kliment/cctwiddler/ccsniffer-assembly/ccsniffer-back-noparts.png

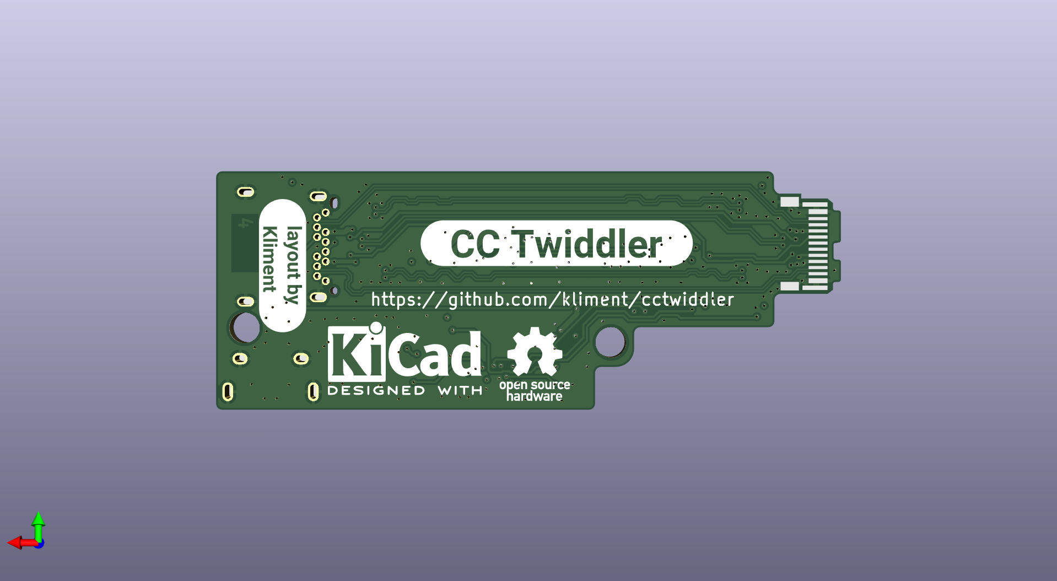
ccsniffer-assembly/ccsniffer-back-noparts.png
