kliment/cctwiddler/ccsniffer-assembly/ccsniffer-bom.xlsx

LIN | RD | Value | Footprint | Quantity | Description | Note | Manufacturer | MPN | Distributor | DPN | URL
1 | C1 | 4.7u | Capacitor_SMD:C_0603_1608Metric | 1 | Capacitor 4.7uF 16V X7R 0603
2 | C2, C3, C9 | 1u | Capacitor_SMD:C_0402_1005Metric | 3 | Capacitor 1uF 10V X7R 0402
3 | C4-C7 | 100n | Capacitor_SMD:C_0402_1005Metric | 4 | Capacitor 100nF 25V X7R 0402
4 | C8 | 10n | Capacitor_SMD:C_0402_1005Metric | 1 | Capacitor 10nF 25V X7R 0402
5 | D1 | MHT194CRGBCT | LED_SMD:LED_LiteOn_LTST-C19HE1WT | 1 | RGB LED |  | Meihua | MHT194CRGBCT | LCSC | C404275 | https://www.lcsc.com/product-detail/Light-Emitting-Diodes-LED_MEIHUA-MHT194CRGBCT_C404275.html
6 | J1 | USB_C_Receptacle | Connector_USB:USB_C_Receptacle_Amphenol_12401548E4-2A | 1 | USB-C 3.1 receptacle hybrid | This part is difficult to source | Amphenol | 12401548E4#2A
7 | J2 | USB_B_Micro | Connector_USB:USB_Micro-B_Amphenol_10118194_Horizontal | 1 | Micro-USB connector |  | Amphenol | 10118194-0001LF
8 | P1 | USB_C_Plug | Connector_USB:USB_C_Plug_JAE_DX07P024AJ1 | 1 | USB-C connector side mount |  | JAE Electronics | DX07P024AJ1R1500 | LCSC | C5352764 | https://www.lcsc.com/product-detail/USB-Connectors_JAE-Electronics-DX07P024AJ1R1500_C5352764.html
9 | Q1-Q6 | PMZ600UNEYL | Package_TO_SOT_SMD:SOT-883 | 6 | N-channel MOSFET |  | Nexperia | PMZ600UNEYL | LCSC | C547286 | https://www.lcsc.com/product-detail/MOSFETs_Nexperia-PMZ600UNEYL_C547286.html
10 | R1, R2 | CSS0805FT15L0 | Resistor_SMD:R_0805_2012Metric | 2 | Current sense R 15mOhm 0.5W 1% 0805 |  | Stackpole Electronics | CSS0805FT15L0 | Digikey |  | https://www.digikey.de/de/products/detail/stackpole-electronics-inc/CSS0805FT15L0/13930229
11 | R3, R11 | 381k | Resistor_SMD:R_0402_1005Metric | 2 | Resistor 381k 1% 0402
12 | R6, R14 | 5.1k | Resistor_SMD:R_0402_1005Metric | 2 | Resistor 5.1k 1% 0402
13 | R7, R15 | 12.1k | Resistor_SMD:R_0402_1005Metric | 2 | Resistor 12.1k 1% 0402
14 | R9, R17 | 100R | Resistor_SMD:R_0402_1005Metric | 2 | Resistor 100R 1% 0402
15 | R10, R18 | 200R | Resistor_SMD:R_0402_1005Metric | 2 | Resistor 200R 1% 0402
16 | R4, R12, R19-R21 | 1k | Resistor_SMD:R_0402_1005Metric | 5 | Resistor 1k 1% 0402
17 | R8, R16, R22 | 35.7k | Resistor_SMD:R_0402_1005Metric | 3 | Resistor 35.7k 1% 0402
18 | R5, R13, R23, R24 | 4.75k | Resistor_SMD:R_0402_1005Metric | 4 | Resistor 4.75k 1% 0402
19 | SW1 | PTS810-SJK-250-SMTR-LFS | Button_Switch_SMD:SW_SPST_PTS810 | 1 | Push button |  | C&K | PTS810-SJK-250-SMTR-LFS | LCSC | C221896 | https://www.lcsc.com/product-detail/Tactile-Switches_C-K-PTS810SJK250SMTRLFS_C221896.html
20 | U1 | STM32F072CBU6 | Package_DFN_QFN:QFN-48-1EP_7x7mm_P0.5mm_EP5.6x5.6mm | 1 | Microcontroller Cortex-M0 |  | STMicroelectronics | STM32F072CBU6 | LCSC | C92504 | https://www.lcsc.com/product-detail/Microcontroller-Units-MCUs-MPUs-SOCs_STMicroelectronics-STM32F072CBU6_C92504.html
21 | U2 | MAX4232AKA+T | Package_TO_SOT_SMD:SOT-23-8 | 1 | Dual opamp SOT-23-8 |  | Analog Devices | MAX4232AKA+T | LCSC | C87614 | https://www.lcsc.com/product-detail/Operational-Amplifier_Analog-Devices-Inc-Maxim-Integrated-MAX4232AKA-T_C87614.html
22 | U3 | TPD4E02B04DQA | Package_SON:USON-10_2.5x1.0mm_P0.5mm | 1 | ESD protection array |  | TI | TPD4E02B04DQA | LCSC | C106794 | https://www.lcsc.com/product-detail/ESD-Protection-Devices_Texas-Instruments-TPD4E02B04DQAR_C106794.html
23 | U4, U5 | INA231AIYFFR | ccsnifferparts:Texas_DSBGA-12_1.65x1.39mm_P0.4mm_YFF0012 | 2 | Current sensor IC |  | TI | INA231AIYFFR | Digikey |  | https://www.digikey.de/en/products/detail/INA231AIYFFR/296-41263-1-ND/5222728?curr=usd
24 | U6 | TCR2EF33,LM(CT | ccsnifferparts:SC-74A | 1 | Voltage regulator 3.3V SC-74A |  | Toshiba | TCR2EF33,LM(CT | LCSC | C843273 | https://www.lcsc.com/product-detail/Linear-Voltage-Regulators-LDO_TOSHIBA-TCR2EF33-LM-CT_C843273.html
