kliment/cctwiddler/ccsniffer.kicad_pcb

## KiCad design ccsniffer.kicad_pcb (2023-10-30)

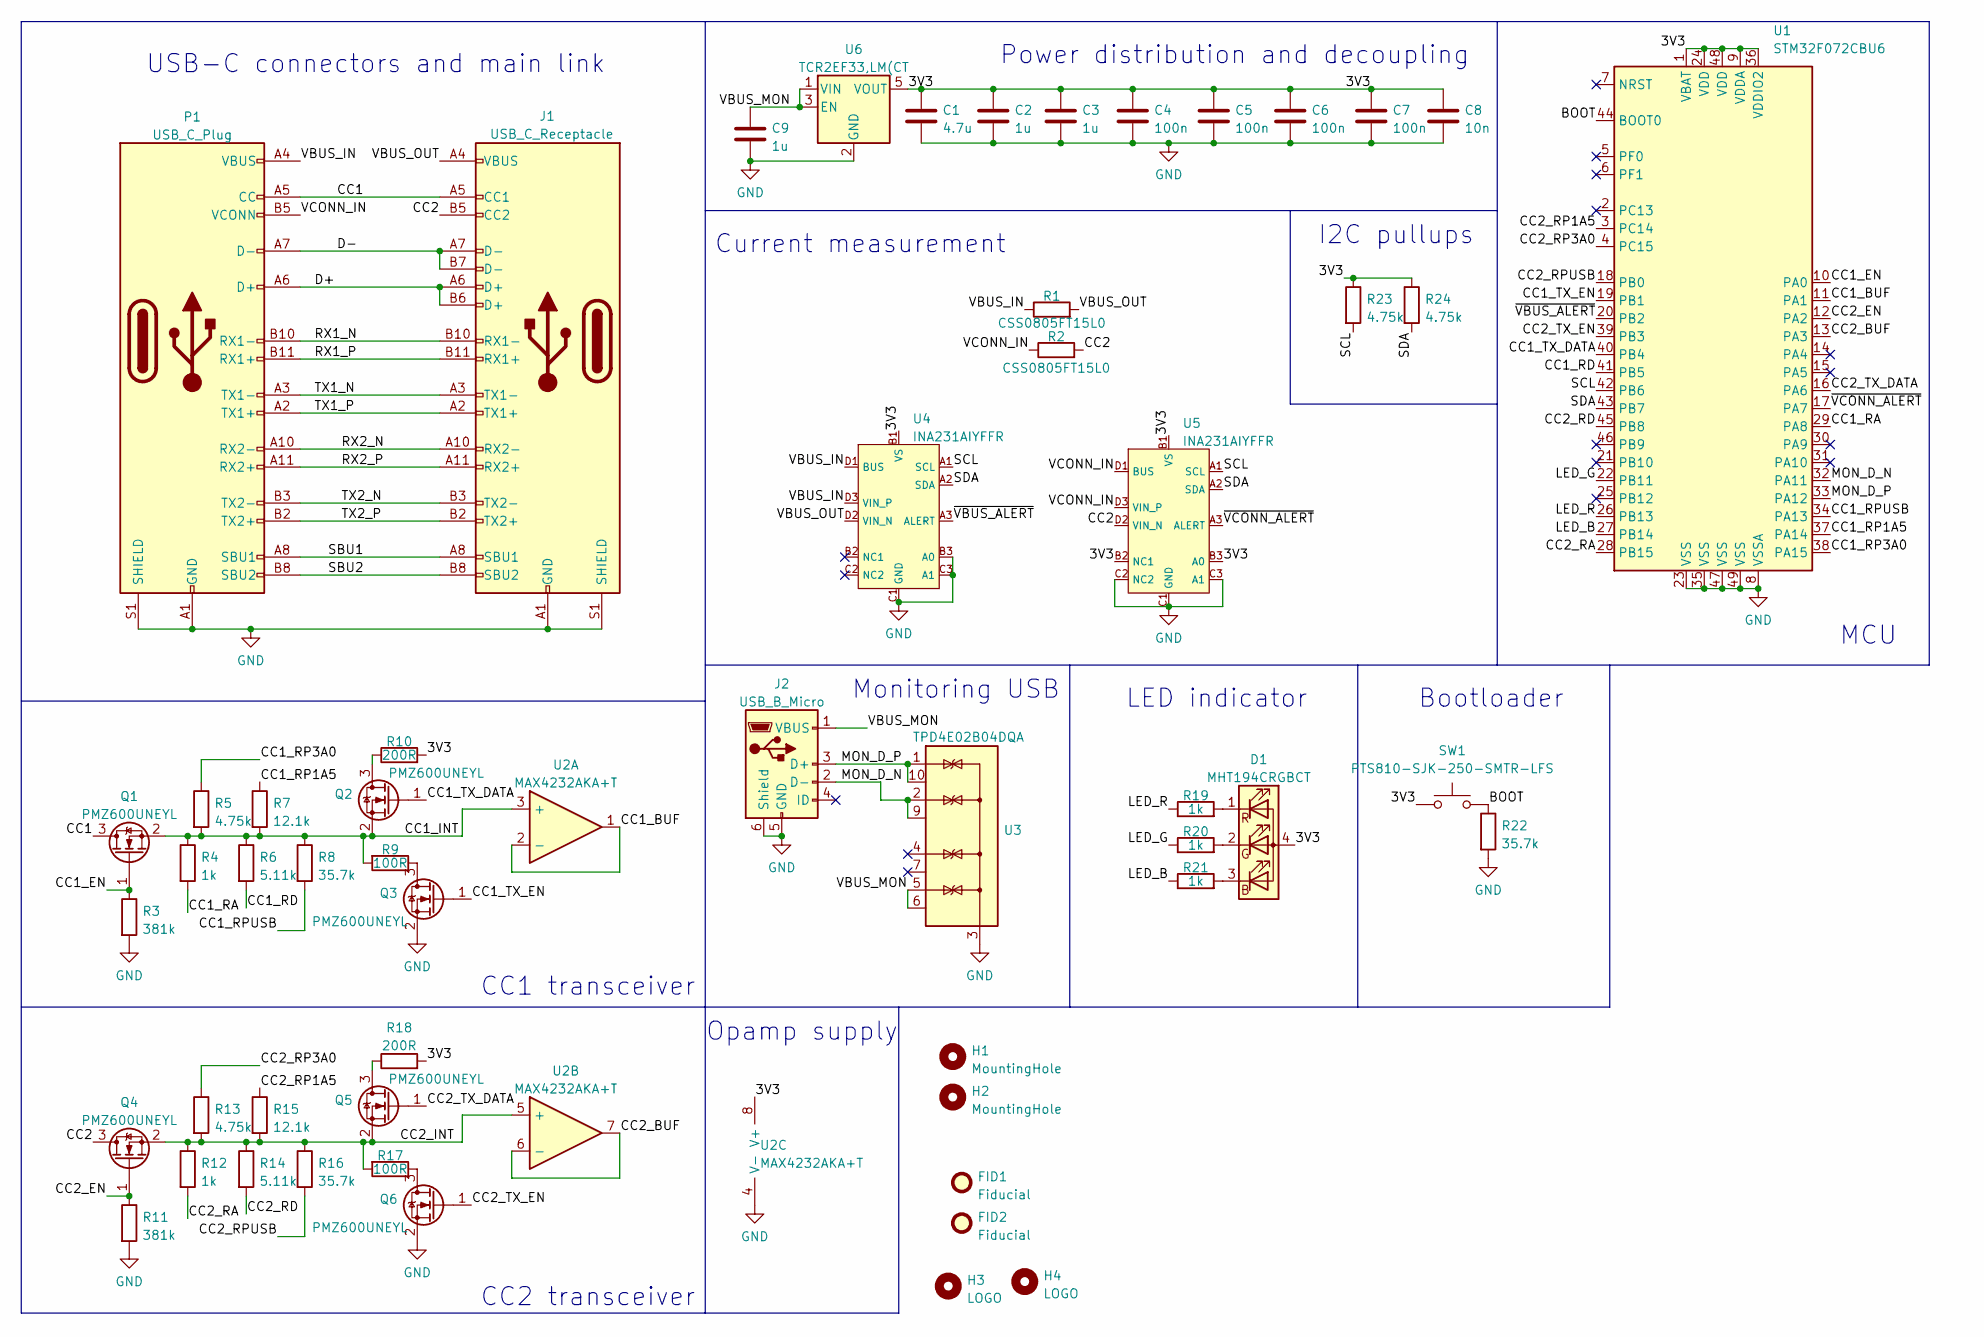
[picture p3: schematic ccsniffer.kicad_sch]

Parts:
C1: 4.7u; C_0603_1608Metric
C2, C3, C9: 1u; C_0402_1005Metric
C4, C5, C6, C7: 100n; C_0402_1005Metric
C8: 10n; C_0402_1005Metric
D1: MHT194CRGBCT; LED_LiteOn_LTST-C19HE1WT; LCSC-Partn C404275
FID1, FID2: Fiducial; Fiducial_0.5mm_Mask1mm
H1, H2: MountingHole; MountingHole_2.5mm
H3: LOGO; KiCad-Logo2_5mm_SilkScreen
H4: LOGO; OSHW-Logo_5.7x6mm_SilkScreen
J1: USB_C_Receptacle; USB_C_Receptacle_Amphenol_12401548E4-2A
J2: USB_B_Micro; USB_Micro-B_Amphenol_10118194_Horizontal
P1: USB_C_Plug; USB_C_Plug_JAE_DX07P024AJ1
Q1, Q2, Q3, Q4, Q5, Q6: PMZ600UNEYL; SOT-883
R1, R2: CSS0805FT15L0; R_0805_2012Metric
R3, R11: 381k; R_0402_1005Metric
R4, R12, R19, R20, R21: 1k; R_0402_1005Metric
R5, R13, R23, R24: 4.75k; R_0402_1005Metric
R6, R14: 5.11k; R_0402_1005Metric
R7, R15: 12.1k; R_0402_1005Metric
R8, R16, R22: 35.7k; R_0402_1005Metric
R9, R17: 100R; R_0402_1005Metric
R10, R18: 200R; R_0402_1005Metric
SW1: PTS810-SJK-250-SMTR-LFS; SW_SPST_PTS810
U1: STM32F072CBU6; QFN-48-1EP_7x7mm_P0.5mm_EP5.6x5.6mm
U2: MAX4232AKA+T; SOT-23-8
U3: TPD4E02B04DQA; USON-10_2.5x1.0mm_P0.5mm
U4, U5: INA231AIYFFR; Texas_DSBGA-12_1.65x1.39mm_P0.4mm_YFF0012
U6: TCR2EF33,LM(CT; SC-74A

Connections:
/3V3: C1.1, C2.1, C3.1, C4.1, C5.1, C6.1, C7.1, C8.1, D1.4 (A), R10.2, R18.2, R23.1, R24.1, SW1.1, U1.1 (VBAT), U1.9 (VDDA), U1.24 (VDD), U1.36 (VDDIO2), U1.48 (VDD), U2.8 (V+), U4.B1 (VS), U5.B1 (VS), U5.B2 (NC1), U5.B3 (A0), U6.5 (VOUT)
/BOOT: R22.1, SW1.2, U1.44 (BOOT0)
/CC1: J1.A5 (CC1), P1.A5 (CC), Q1.3 (D)
/CC1_BUF: U1.11 (PA1), U2.1, U2.2 (-)
/CC1_EN: Q1.1 (G), R3.1, U1.10 (PA0)
/CC1_INT: Q1.2 (S), Q2.2 (S), R4.1, R5.2, R6.1, R7.2, R8.1, R9.2, U2.3 (+)
/CC1_RA: R4.2, U1.29 (PA8)
/CC1_RD: R6.2, U1.41 (PB5)
/CC1_RP1A5: R7.1, U1.37 (PA14)
/CC1_RP3A0: R5.1, U1.38 (PA15)
/CC1_RPUSB: R8.2, U1.34 (PA13)
/CC1_TX_DATA: Q2.1 (G), U1.40 (PB4)
/CC1_TX_EN: Q3.1 (G), U1.19 (PB1)
/CC2: J1.B5 (CC2), Q4.3 (D), R2.2, U5.D2 (VIN_N)
/CC2_BUF: U1.13 (PA3), U2.6 (-), U2.7
/CC2_EN: Q4.1 (G), R11.1, U1.12 (PA2)
/CC2_INT: Q4.2 (S), Q5.2 (S), R12.1, R13.2, R14.1, R15.2, R16.1, R17.2, U2.5 (+)
/CC2_RA: R12.2, U1.28 (PB15)
/CC2_RD: R14.2, U1.45 (PB8)
/CC2_RP1A5: R15.1, U1.3 (PC14)
/CC2_RP3A0: R13.1, U1.4 (PC15)
/CC2_RPUSB: R16.2, U1.18 (PB0)
/CC2_TX_DATA: Q5.1 (G), U1.16 (PA6)
/CC2_TX_EN: Q6.1 (G), U1.39 (PB3)
/D+: J1.A6 (D+), J1.B6 (D+), P1.A6 (D+)
/D-: J1.A7 (D-), J1.B7 (D-), P1.A7 (D-)
/LED_B: R21.1, U1.27 (PB14)
/LED_G: R20.1, U1.22 (PB11)
/LED_R: R19.1, U1.26 (PB13)
/MON_D_N: J2.2 (D-), U1.32 (PA11), U3.2 (IO2), U3.9 (NC)
/MON_D_P: J2.3 (D+), U1.33 (PA12), U3.1 (IO1), U3.10 (NC)
/RX1_N: J1.B10 (RX1-), P1.B10 (RX1-)
/RX1_P: J1.B11 (RX1+), P1.B11 (RX1+)
/RX2_N: J1.A10 (RX2-), P1.A10 (RX2-)
/RX2_P: J1.A11 (RX2+), P1.A11 (RX2+)
/SBU1: J1.A8 (SBU1), P1.A8 (SBU1)
/SBU2: J1.B8 (SBU2), P1.B8 (SBU2)
/SCL: R23.2, U1.42 (PB6), U4.A1 (SCL), U5.A1 (SCL)
/SDA: R24.2, U1.43 (PB7), U4.A2 (SDA), U5.A2 (SDA)
/TX1_N: J1.A3 (TX1-), P1.A3 (TX1-)
/TX1_P: J1.A2 (TX1+), P1.A2 (TX1+)
/TX2_N: J1.B3 (TX2-), P1.B3 (TX2-)
/TX2_P: J1.B2 (TX2+), P1.B2 (TX2+)
/VBUS_IN: P1.A4 (VBUS), P1.A9 (VBUS), P1.B4 (VBUS), P1.B9 (VBUS), R1.1, U4.D1 (BUS), U4.D3 (VIN_P)
/VBUS_MON: C9.1, J2.1 (VBUS), U3.5 (IO4), U3.6 (NC), U6.1 (VIN), U6.3 (EN)
/VBUS_OUT: J1.A4 (VBUS), J1.A9 (VBUS), J1.B4 (VBUS), J1.B9 (VBUS), R1.2, U4.D2 (VIN_N)
/VCONN_IN: P1.B5 (VCONN), R2.1, U5.D1 (BUS), U5.D3 (VIN_P)
/~VBUS_ALERT: U1.20 (PB2), U4.A3 (ALERT)
/~VCONN_ALERT: U1.17 (PA7), U5.A3 (ALERT)
GND: C1.2, C2.2, C3.2, C4.2, C5.2, C6.2, C7.2, C8.2, C9.2, J1.A1 (GND), J1.A12 (GND), J1.B1 (GND), J1.B12 (GND), J1.S1 (SHIELD), J2.5 (GND), J2.6 (Shield), P1.A1 (GND), P1.A12 (GND), P1.B1 (GND), P1.B12 (GND), P1.S1 (SHIELD), Q3.2 (S), Q6.2 (S), R3.2, R11.2, R22.2, U1.8 (VSSA), U1.23 (VSS), U1.35 (VSS), U1.47 (VSS), U1.49 (VSS), U2.4 (V-), U3.3 (G), U3.8 (G), U4.B3 (A0), U4.C1 (GND), U4.C3 (A1), U5.C1 (GND), U5.C2 (NC2), U5.C3 (A1), U6.2 (GND)
unnamed: D1.1 (RK), R19.2
unnamed: D1.2 (GK), R20.2
unnamed: D1.3 (BK), R21.2
unnamed: Q2.3 (D), R10.1
unnamed: Q3.3 (D), R9.1
unnamed: Q5.3 (D), R18.1
unnamed: Q6.3 (D), R17.1

Notes on the sheet:
LED indicator
I2C pullups
Monitoring USB
Opamp supply
CC1 transceiver
Bootloader
MCU
Current measurement
USB-C connectors and main link
CC2 transceiver
Power distribution and decoupling

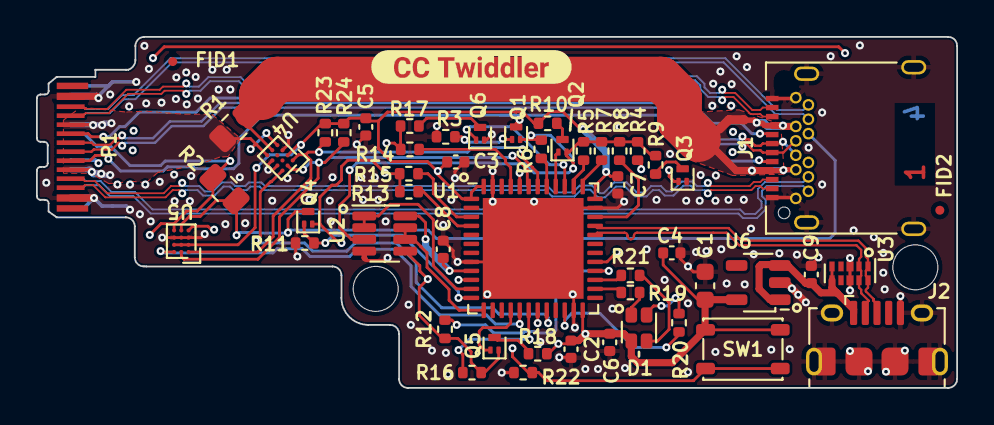
[picture p4: board ccsniffer.kicad_pcb from above]

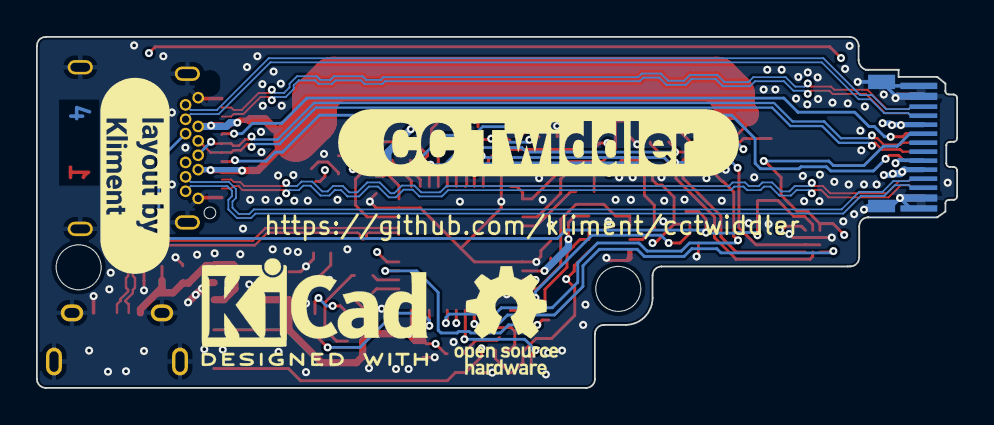
[picture p5: board ccsniffer.kicad_pcb from below]

Board: 4 copper layers, 51.1 x 19.5 mm, 59 parts (4 on the bottom side), 57 nets.

Other parts of the board:
kibuzzard-63CB0A6D: G***; kibuzzard-63CB0A6D
kibuzzard-63CB0ABC: G***; kibuzzard-63CB0ABC
kibuzzard-63CB09FB: G***; kibuzzard-63CB09FB
