kliment/cctwiddler/ccsniffer-assembly/ccsniffer-front-noparts.png

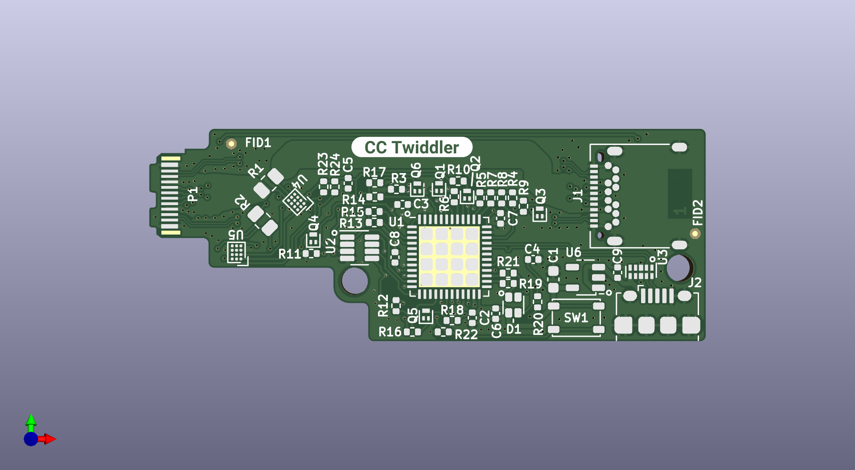
ccsniffer-assembly/ccsniffer-front-noparts.png
