kliment/cctwiddler/ccsniffer-assembly/ccsniffer-front.png

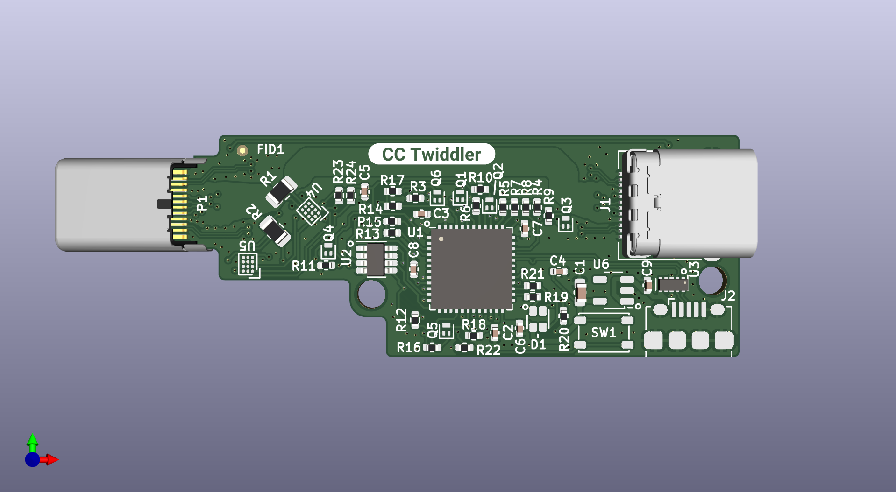
ccsniffer-assembly/ccsniffer-front.png
